PajamaLlamaLand/LessThanThree/GateDr/hardware/gateDr_displayboard/gateDr_displayboard.kicad_pcb

## KiCad design GateDr/hardware/gateDr_displayboard/gateDr_displayboard.kicad_pcb (2025-09-23)

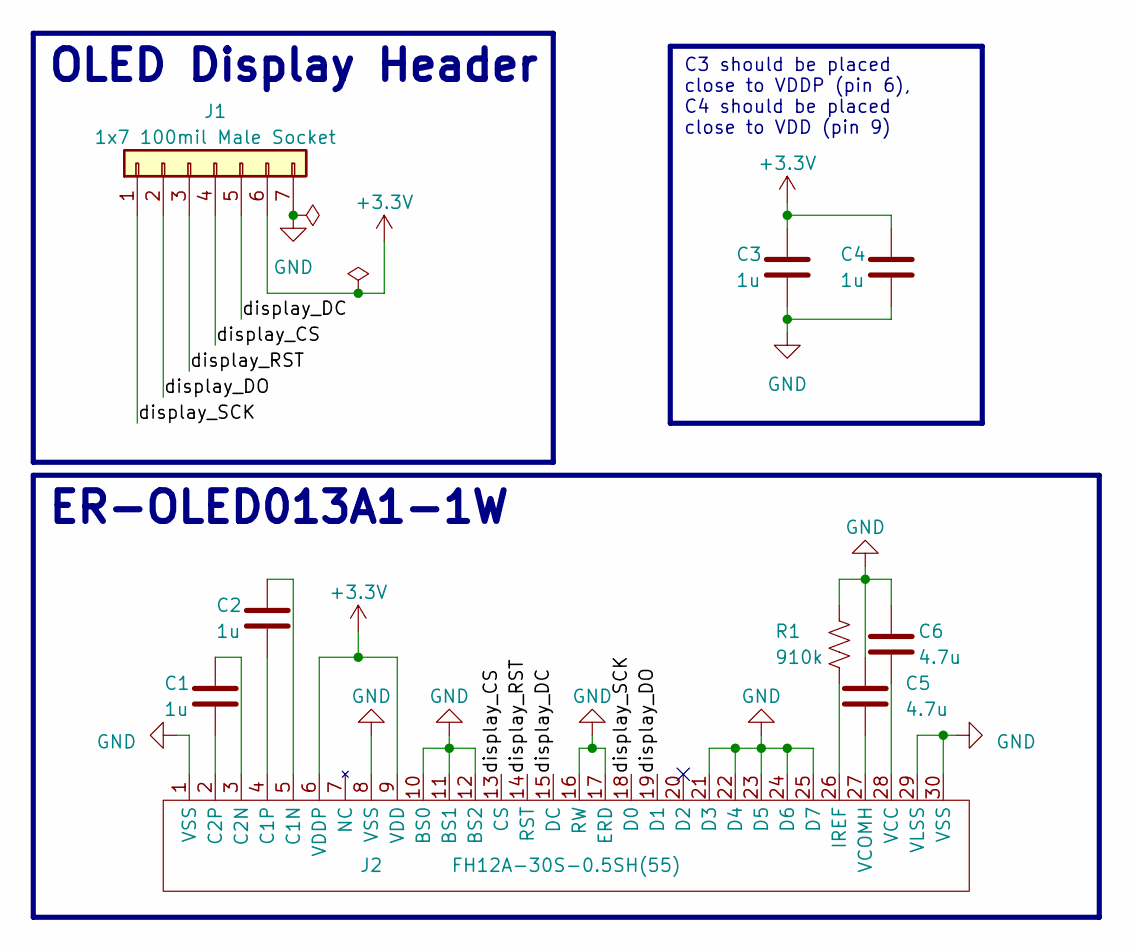
[picture p5: schematic gateDr_displayboard.kicad_sch]

Parts:
C1, C2, C3, C4: 1u; C_0603_1608Metric; Mouser Part No. GCM188R71E105KA64D
C5, C6: 4.7u; C_0603_1608Metric; Mouser Part No. GRM188Z71C475KE21D
J1: 1x7 100mil Male Socket; PinHeader_1x07_P2.54mm_Vertical
J2: FH12A-30S-0.5SH(55); FH12A-30S-0.5SH
R1: 910k; R_0402_1005Metric; Mouser Part No. CRCW0402910KFKED

Connections:
+3.3V: C3.1, C4.1, J1.6, J2.6 (VDDP), J2.9 (VDD)
/display_CS: J1.4, J2.13 (CS)
/display_DC: J1.5, J2.15 (DC)
/display_DO: J1.2, J2.19 (D1)
/display_RST: J1.3, J2.14 (RST)
/display_SCK: J1.1, J2.18 (D0)
GND: C3.2, C4.2, C5.1, C6.1, J1.7, J2.1 (VSS), J2.8 (VSS), J2.10 (BS0), J2.11 (BS1), J2.12 (BS2), J2.16 (RW), J2.17 (ERD), J2.21 (D3), J2.22 (D4), J2.23 (D5), J2.24 (D6), J2.25 (D7), J2.29 (VLSS), J2.30 (VSS), R1.1
unnamed: C2.1, J2.5 (C1N)
unnamed: C2.2, J2.4 (C1P)
unnamed: C1.1, J2.3 (C2N)
unnamed: C1.2, J2.2 (C2P)
unnamed: J2.26 (IREF), R1.2
unnamed: C6.2, J2.28 (VCC)
unnamed: C5.2, J2.27 (VCOMH)

Notes on the sheet:
ER-OLED013A1-1W
C3 should be placed close to VDDP (pin 6), C4 should be placed close to VDD (pin 9)
OLED Display Header

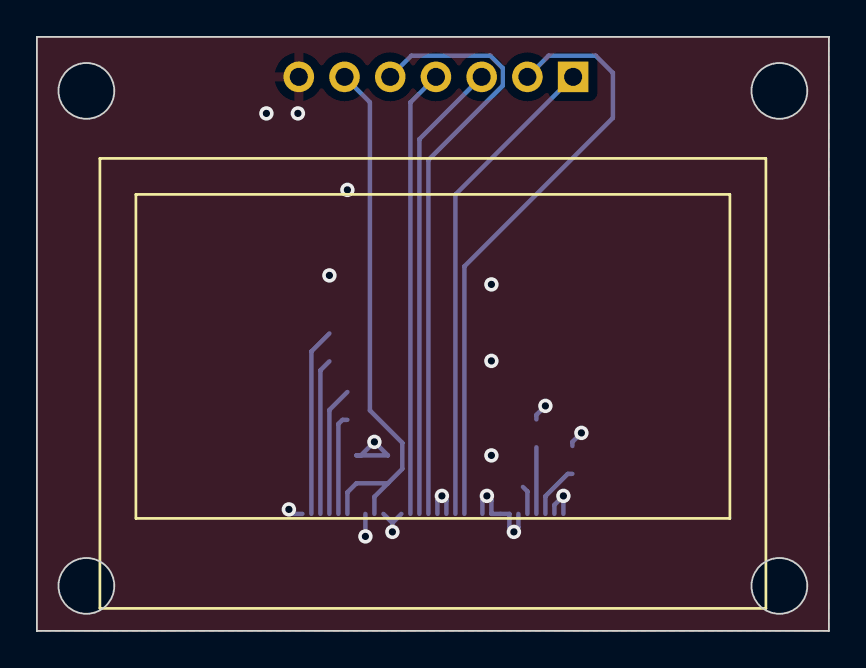
[picture p6: board gateDr_displayboard.kicad_pcb from above]

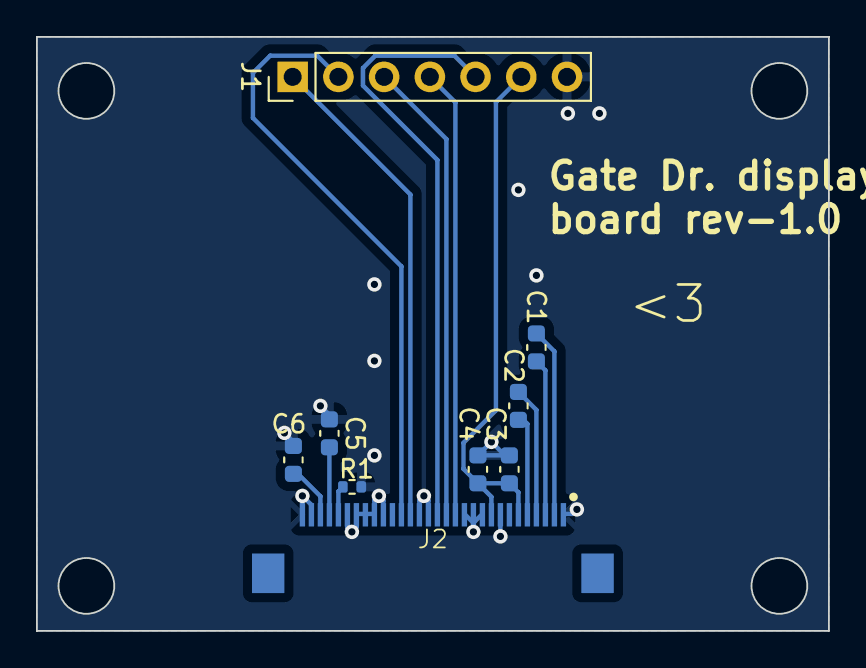
[picture p7: board gateDr_displayboard.kicad_pcb from below]

Board: 2 copper layers, 44.0 x 33.0 mm, 9 parts (9 on the bottom side), 14 nets.
