PajamaLlamaLand/LessThanThree/GateDr/hardware/gateDr_mainboard/gateDr_mainboard.kicad_pcb

## KiCad design GateDr/hardware/gateDr_mainboard/gateDr_mainboard.kicad_pcb (2025-09-23)

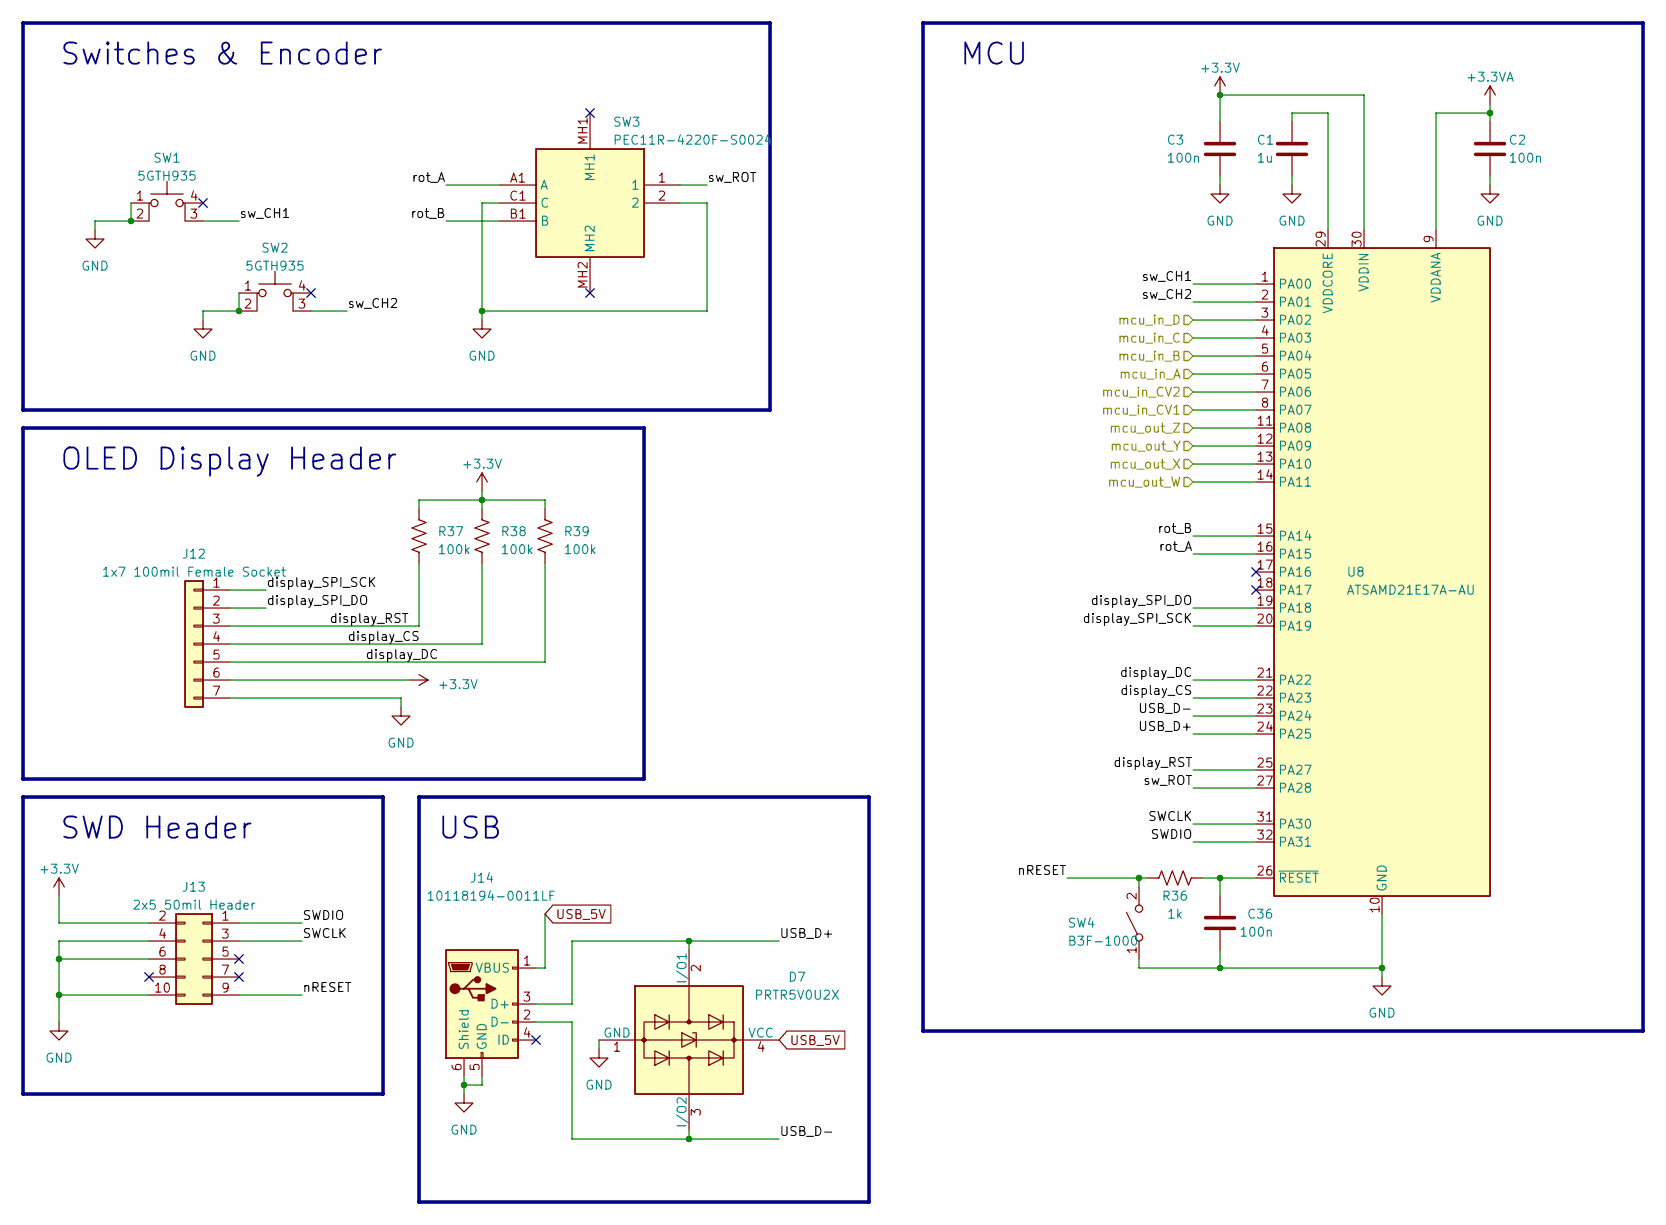
[picture p8: schematic mcu.kicad_sch]

Parts:
C1: 1u; C_0603_1608Metric; Mouser Part No. GCM188R71E105KA64D
C2, C3, C36: 100n; C_0402_1005Metric; Mouser Part No. GRM155R71H104KE14J
D7: PRTR5V0U2X; SOT-143; Mouser Part No. 771-PRTR5V0U2X-T/R
J12: 1x7 100mil Female Socket; PinSocket_1x07_P2.54mm_Vertical
J13: 2x5 50mil Header; PinSocket_2x05_P1.27mm_Vertical
J14: 10118194-0011LF; USB_Micro-B_Amphenol_10118194_Horizontal; Mouser Part No. 649-10118194-0011LF
R36: 1k; R_0402_1005Metric; Mouser Part No. CRCW04021K00FKED
R37, R38, R39: 100k; R_0402_1005Metric; Mouser Part No. CRCW0402100KFKED
SW1, SW2: 5GTH935
SW3: PEC11R-4220F-S0024; PEC11R4220FS0024; Mouser Part Number 652-PEC11R-4220F-S24
SW4: B3F-1000; SW_PUSH_6mm_H4.3mm
U8: ATSAMD21E17A-AU; TQFP-32_7x7mm_P0.8mm

Connections:
+3.3V: C3.1, J12.6, J13.2, R37.1, R38.1, R39.1, U8.30 (VDDIN); also elsewhere on the board
+3.3VA: C2.1, U8.9 (VDDANA); also elsewhere on the board
/Inputs/in_A: U8.6 (PA05); also elsewhere on the board
/Inputs/in_B: U8.5 (PA04); also elsewhere on the board
/Inputs/in_C: U8.4 (PA03); also elsewhere on the board
/Inputs/in_CV1: U8.8 (PA07); also elsewhere on the board
/Inputs/in_CV2: U8.7 (PA06); also elsewhere on the board
/Inputs/in_D: U8.3 (PA02); also elsewhere on the board
/MCU/SWCLK: J13.3, U8.31 (PA30)
/MCU/SWDIO: J13.1, U8.32 (PA31)
/MCU/USB_D+: D7.2 (I/O1), J14.3 (D+), U8.24 (PA25)
/MCU/USB_D-: D7.3 (I/O2), J14.2 (D-), U8.23 (PA24)
/MCU/display_CS: J12.4, R38.2, U8.22 (PA23)
/MCU/display_DC: J12.5, R39.2, U8.21 (PA22)
/MCU/display_RST: J12.3, R37.2, U8.25 (PA27)
/MCU/display_SPI_DO: J12.2, U8.19 (PA18)
/MCU/display_SPI_SCK: J12.1, U8.20 (PA19)
/MCU/mcu_out_W: U8.14 (PA11); also elsewhere on the board
/MCU/mcu_out_X: U8.13 (PA10); also elsewhere on the board
/MCU/mcu_out_Y: U8.12 (PA09); also elsewhere on the board
/MCU/mcu_out_Z: U8.11 (PA08); also elsewhere on the board
/MCU/nRESET: J13.9, R36.1, SW4.2 (B)
/MCU/rot_A: SW3.A1 (A), U8.16 (PA15)
/MCU/rot_B: SW3.B1 (B), U8.15 (PA14)
/MCU/sw_CH1: SW1.3 (K), U8.1 (PA00)
/MCU/sw_CH2: SW2.3 (K), U8.2 (PA01)
/MCU/sw_ROT: SW3.1, U8.27 (PA28)
GND: C1.2, C2.2, C3.2, C36.2, D7.1 (GND), J12.7, J13.4, J13.6, J13.10, J14.5 (GND), J14.6 (Shield), SW1.1, SW1.2, SW2.1, SW2.2, SW3.2, SW3.C1 (C), SW4.1 (A), U8.10 (GND), U8.28 (GND); also elsewhere on the board
unnamed: C1.1, U8.29 (VDDCORE)
unnamed: C36.1, R36.2, U8.26 (~RESET)
USB_5V: D7.4 (VCC), J14.1 (VBUS); also elsewhere on the board

Notes on the sheet:
Switches & Encoder
SWD Header
USB
OLED Display Header
MCU

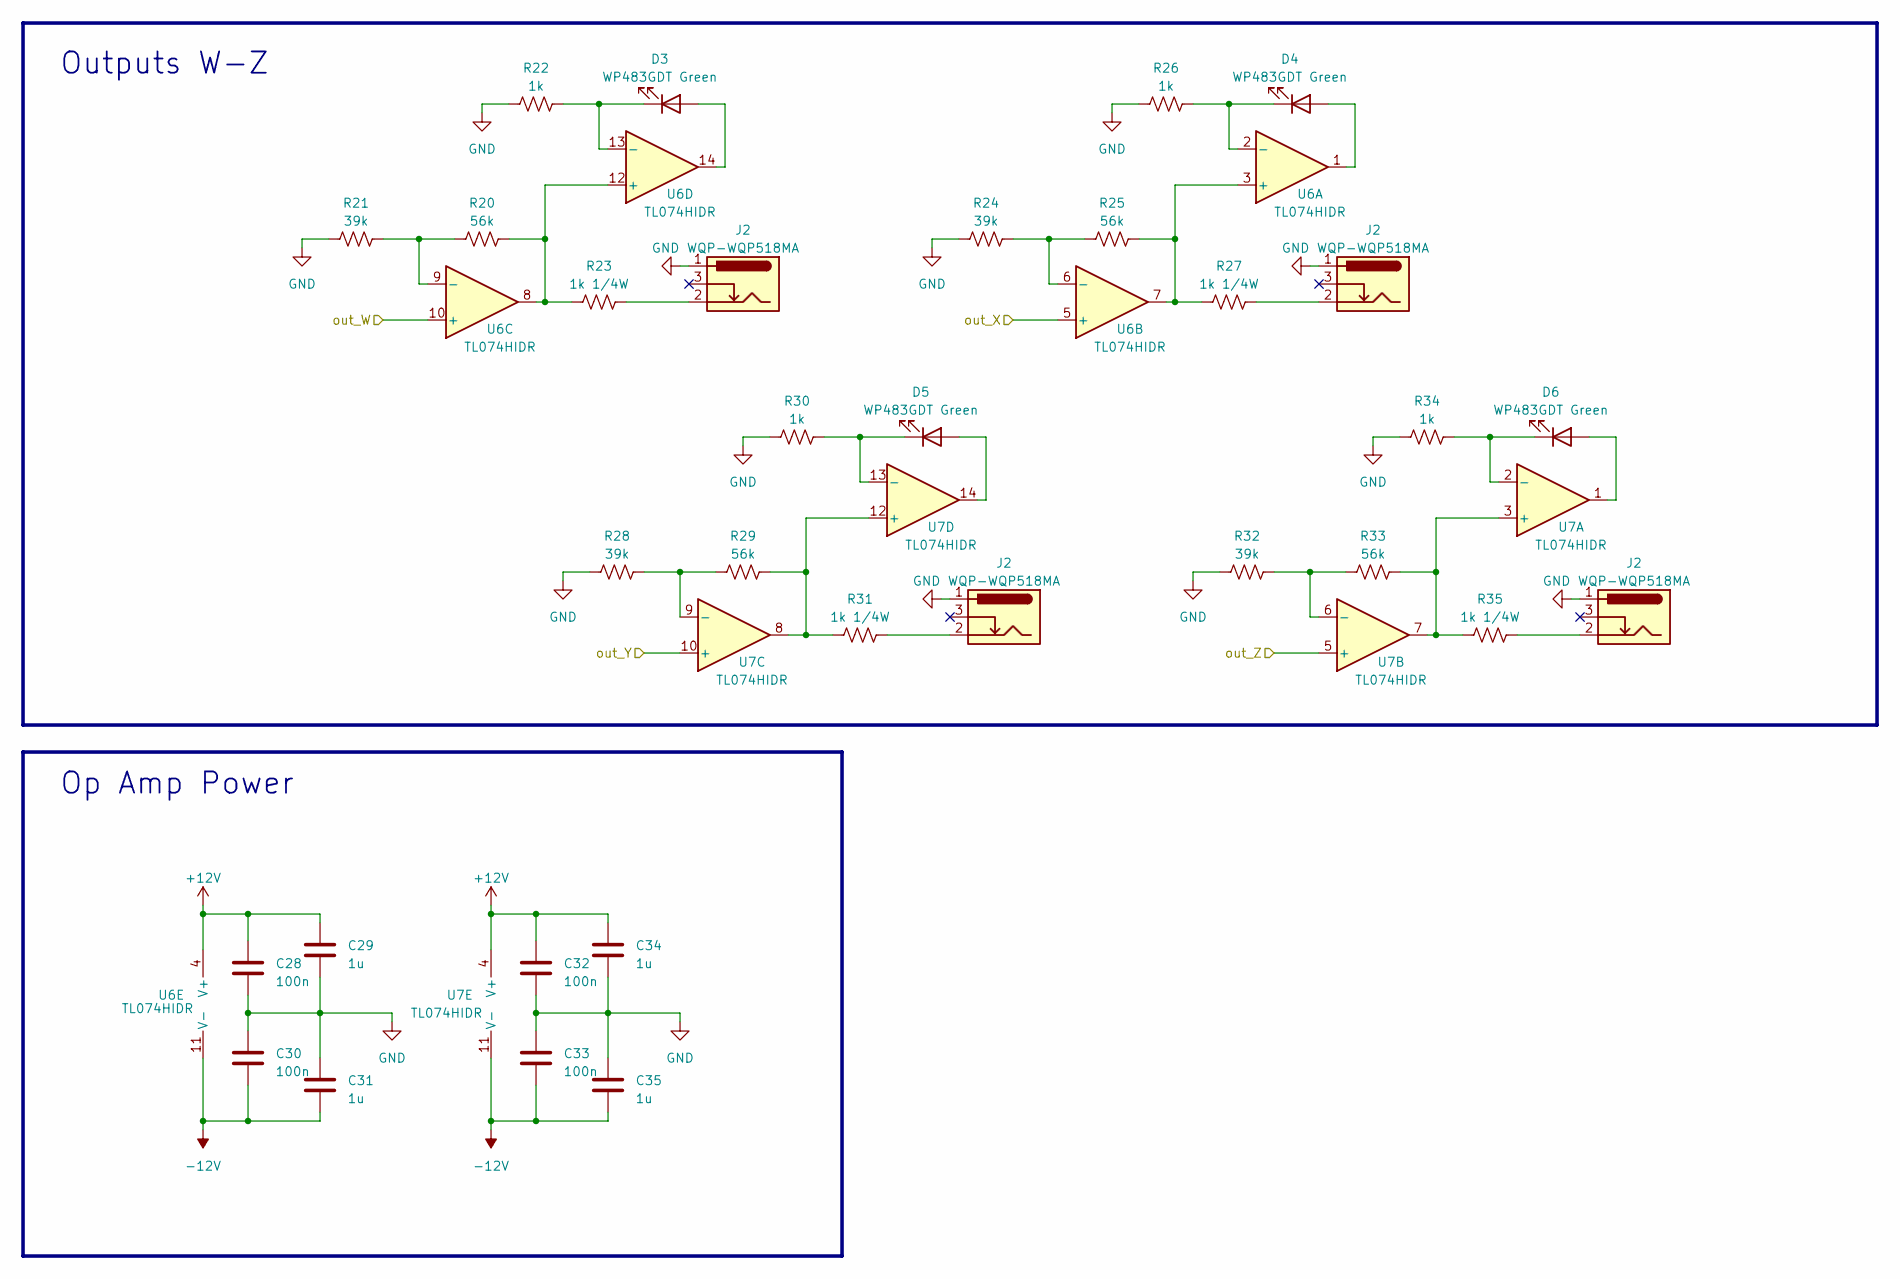
[picture p9: schematic outputs.kicad_sch]

Parts:
C28, C30, C32, C33: 100n; C_0402_1005Metric; Mouser Part No. GRM155R71H104KE14J
C29, C31, C34, C35: 1u; C_0603_1608Metric; Mouser Part No. GCM188R71E105KA64D
D3, D4, D5, D6: WP483GDT Green; LED_D5.0mm_FlatTop
J2: WQP-WQP518MA; AudioJack_WQP518MA
R20, R25, R29, R33: 56k; R_0402_1005Metric; Mouser Part No. CRCW040256K0FKED
R21, R24, R28, R32: 39k; R_0402_1005Metric; Mouser Part No. CRCW040239K0FKED
R22, R26, R30, R34: 1k; R_0402_1005Metric; Mouser Part No. CRCW04021K00FKED
R23, R27, R31, R35: 1k 1/4W; R_0805_2012Metric; Mouser Part No. RCC08051K00FKEA
U6, U7: TL074HIDR; SOIC-14_3.9x8.7mm_P1.27mm

Connections:
+12V: C28.1, C29.1, C32.1, C34.1, U6.4 (V+), U7.4 (V+); also elsewhere on the board
-12V: C30.2, C31.2, C33.2, C35.2, U6.11 (V-), U7.11 (V-); also elsewhere on the board
/MCU/mcu_out_W: U6.10 (+); also elsewhere on the board
/MCU/mcu_out_X: U6.5 (+); also elsewhere on the board
/MCU/mcu_out_Y: U7.10 (+); also elsewhere on the board
/MCU/mcu_out_Z: U7.5 (+); also elsewhere on the board
GND: C28.2, C29.2, C30.1, C31.1, C32.2, C33.1, C34.2, C35.1, J2.1, J2.3, R21.1, R22.1, R24.1, R26.1, R28.1, R30.1, R32.1, R34.1; also elsewhere on the board
unnamed: D3.2 (A), U6.14
unnamed: D3.1 (K), R22.2, U6.13 (-)
unnamed: D4.2 (A), U6.1
unnamed: D4.1 (K), R26.2, U6.2 (-)
unnamed: D5.2 (A), U7.14
unnamed: D5.1 (K), R30.2, U7.13 (-)
unnamed: D6.2 (A), U7.1
unnamed: D6.1 (K), R34.2, U7.2 (-)
unnamed: R25.2, R27.1, U6.3 (+), U6.7
unnamed: R24.2, R25.1, U6.6 (-)
unnamed: R20.1, R21.2, U6.9 (-)
unnamed: R20.2, R23.1, U6.8, U6.12 (+)
unnamed: R33.2, R35.1, U7.3 (+), U7.7
unnamed: R32.2, R33.1, U7.6 (-)
unnamed: R28.2, R29.1, U7.9 (-)
unnamed: R29.2, R31.1, U7.8, U7.12 (+)

Notes on the sheet:
Op Amp Power
Outputs W-Z

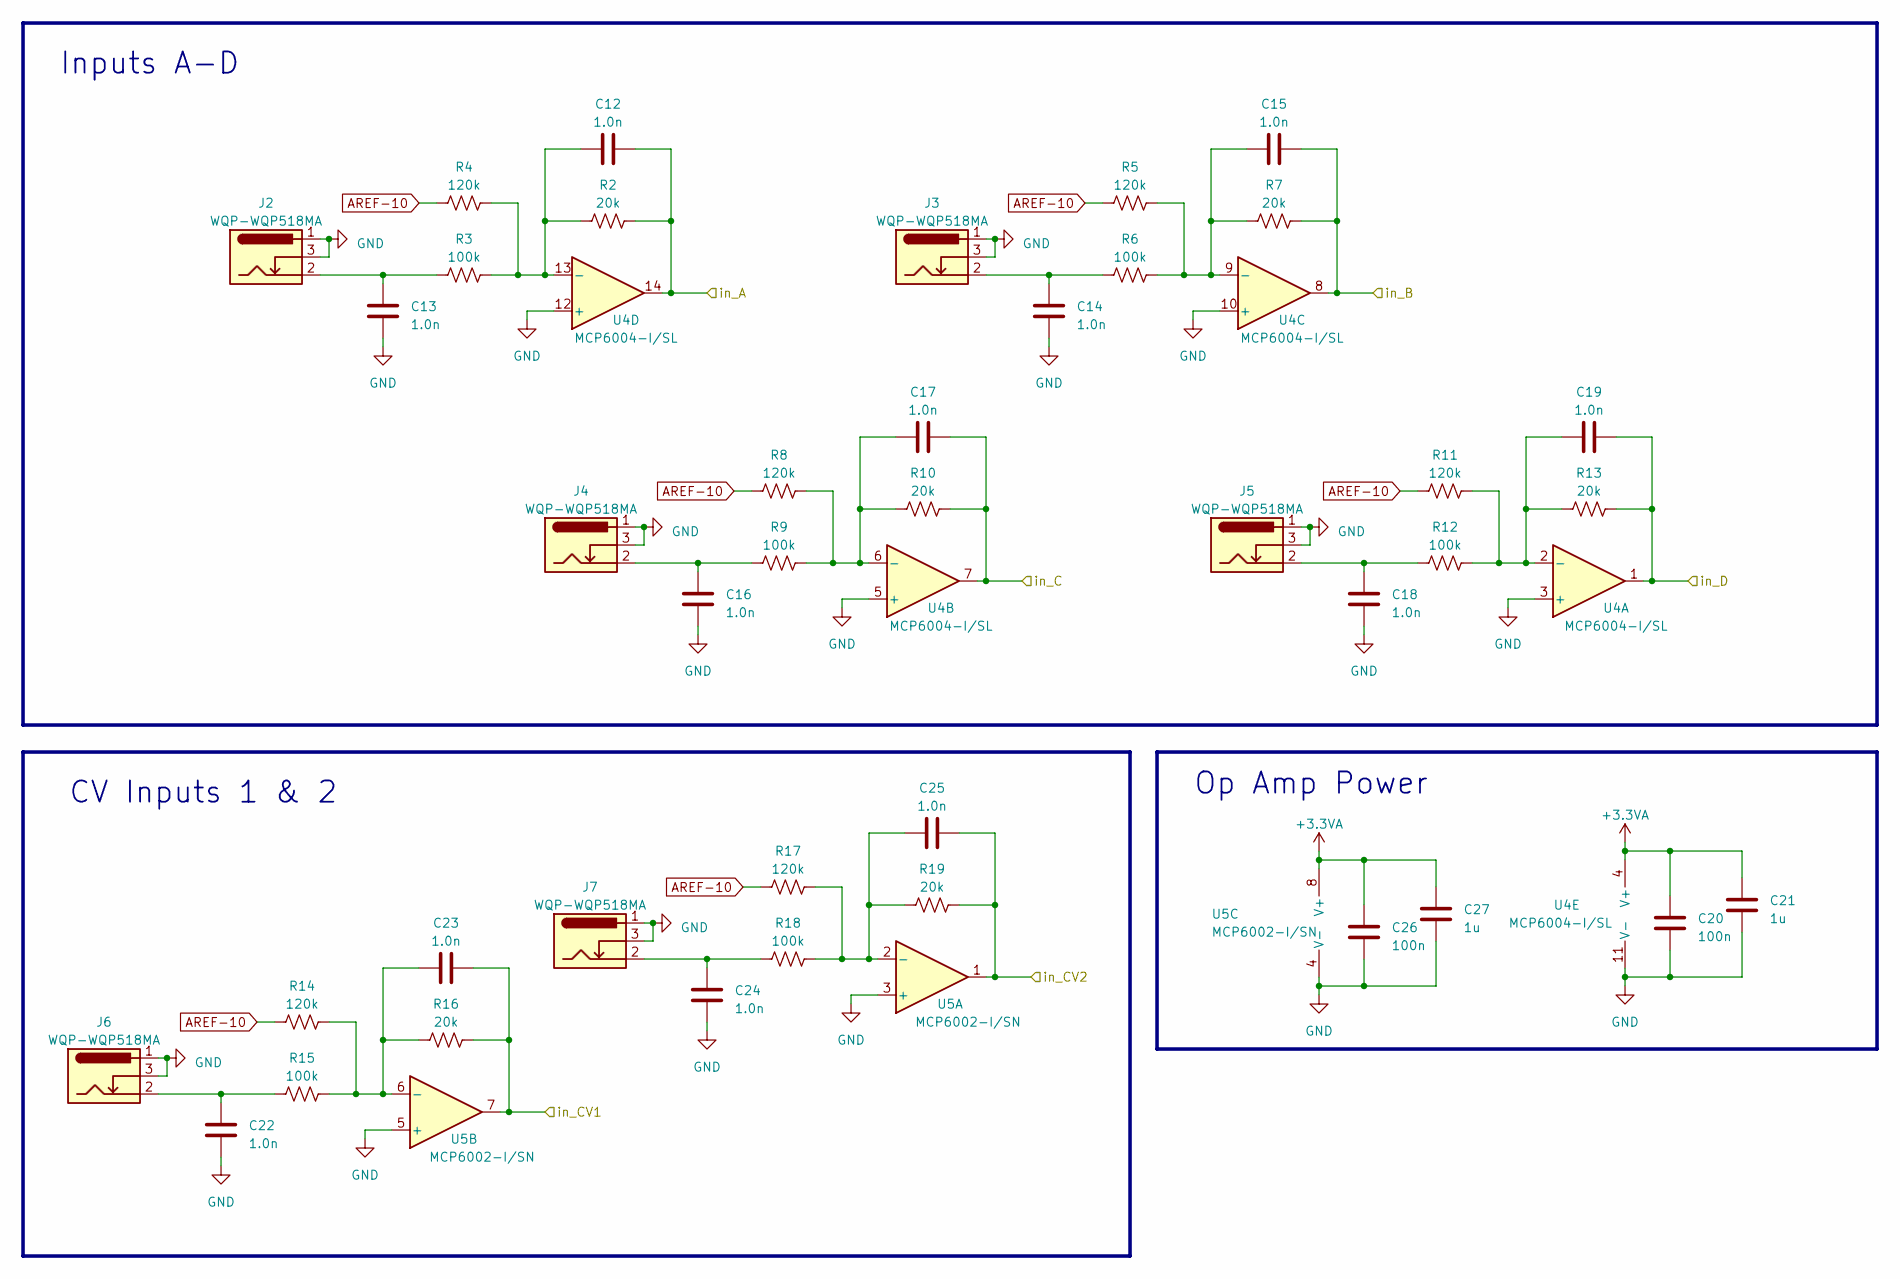
[picture p10: schematic inputs.kicad_sch]

Parts:
C12, C13, C14, C15, C16, C17, C18, C19, C22, C23, C24, C25: 1.0n; C_0402_1005Metric; Mouser Part No. GRM155R71H102KA01J
C20, C26: 100n; C_0402_1005Metric; Mouser Part No. GRM155R71H104KE14J
C21, C27: 1u; C_0603_1608Metric; Mouser Part No. GCM188R71E105KA64D
J2, J3, J4, J5, J6, J7: WQP-WQP518MA; AudioJack_WQP518MA
R2, R7, R10, R13, R16, R19: 20k; R_0402_1005Metric; Mouser Part No. CRCW040220K0FKED
R3, R6, R9, R12, R15, R18: 100k; R_0402_1005Metric; Mouser Part No. CRCW0402100KFKED
R4, R5, R8, R11, R14, R17: 120k; R_0402_1005Metric; Mouser Part No. CRCW0402120KFKED
U4: MCP6004-I/SL; SOIC-14_3.9x8.7mm_P1.27mm
U5: MCP6002-I/SN; SOIC-8_3.9x4.9mm_P1.27mm

Connections:
+3.3VA: C20.1, C21.1, C26.1, C27.1, U4.4 (V+), U5.8 (V+); also elsewhere on the board
/Inputs/in_A: C12.2, R2.2, U4.14; also elsewhere on the board
/Inputs/in_B: C15.2, R7.2, U4.8; also elsewhere on the board
/Inputs/in_C: C17.2, R10.2, U4.7; also elsewhere on the board
/Inputs/in_CV1: C23.2, R16.2, U5.7; also elsewhere on the board
/Inputs/in_CV2: C25.2, R19.2, U5.1; also elsewhere on the board
/Inputs/in_D: C19.2, R13.2, U4.1; also elsewhere on the board
AREF-10: R4.1, R5.1, R8.1, R11.1, R14.1, R17.1; also elsewhere on the board
GND: C13.2, C14.2, C16.2, C18.2, C20.2, C21.2, C22.2, C24.2, C26.2, C27.2, J2.1, J2.3, J3.1, J3.3, J4.1, J4.3, J5.1, J5.3, J6.1, J6.3, J7.1, J7.3, U4.3 (+), U4.5 (+), U4.10 (+), U4.11 (V-), U4.12 (+), U5.3 (+), U5.4 (V-), U5.5 (+); also elsewhere on the board
unnamed: C14.1, J3.2, R6.1
unnamed: C16.1, J4.2, R9.1
unnamed: C18.1, J5.2, R12.1
unnamed: C22.1, J6.2, R15.1
unnamed: C24.1, J7.2, R18.1
unnamed: C19.1, R11.2, R12.2, R13.1, U4.2 (-)
unnamed: C17.1, R8.2, R9.2, R10.1, U4.6 (-)
unnamed: C15.1, R5.2, R6.2, R7.1, U4.9 (-)
unnamed: C12.1, R2.1, R3.2, R4.2, U4.13 (-)
unnamed: C25.1, R17.2, R18.2, R19.1, U5.2 (-)
unnamed: C23.1, R14.2, R15.2, R16.1, U5.6 (-)

Notes on the sheet:
Inputs A-D
CV Inputs 1 & 2
Op Amp Power

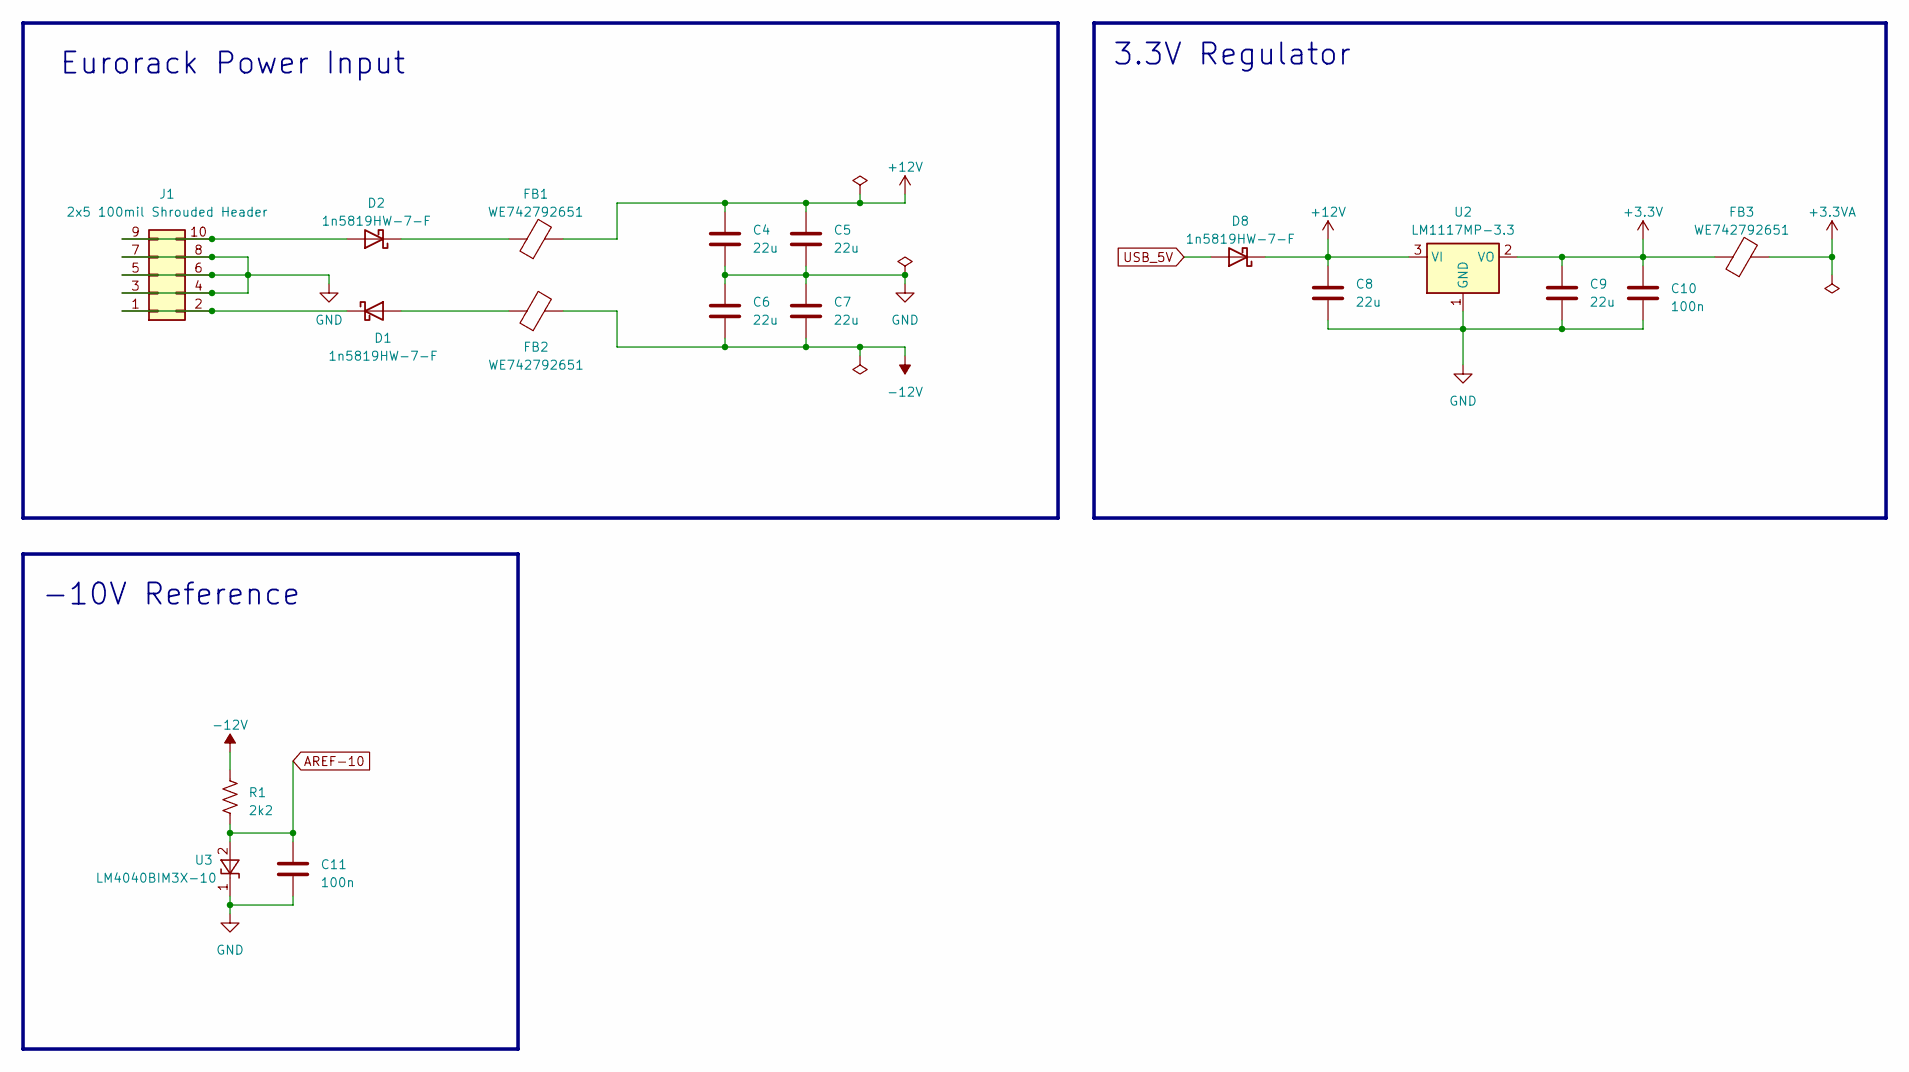
[picture p11: schematic power.kicad_sch]

Parts:
C4, C5, C6, C7, C8, C9: 22u; C_0805_2012Metric; Mouser Part No. CL21A226MAYNNNE
C10, C11: 100n; C_0402_1005Metric; Mouser Part No. GRM155R71H104KE14J
D1, D2, D8: 1n5819HW-7-F; D_SOD-123
FB1, FB2, FB3: WE742792651; BEADC1608X100N
J1: 2x5 100mil Shrouded Header; IDC-Header_2x05_P2.54mm_Vertical
R1: 2k2; R_0402_1005Metric; Mouser Part No. CRCW04022K20FKED
U2: LM1117MP-3.3; SOT-223-3_TabPin2
U3: LM4040BIM3X-10; SOT-23

Connections:
+3.3V: C9.1, C10.1, FB3.1, U2.2 (VO); also elsewhere on the board
+3.3VA: FB3.2; also elsewhere on the board
+12V: C4.1, C5.1, C8.1, D8.1 (K), FB1.2, U2.3 (VI); also elsewhere on the board
-12V: C6.2, C7.2, FB2.2, R1.1; also elsewhere on the board
AREF-10: C11.1, R1.2, U3.2 (A); also elsewhere on the board
GND: C4.2, C5.2, C6.1, C7.1, C8.2, C9.2, C10.2, C11.2, J1.3, J1.4, J1.5, J1.6, J1.7, J1.8, U2.1 (GND), U3.1 (K); also elsewhere on the board
unnamed: D1.2 (A), FB2.1
unnamed: D1.1 (K), J1.1, J1.2
unnamed: D2.2 (A), J1.9, J1.10
unnamed: D2.1 (K), FB1.1
USB_5V: D8.2 (A); also elsewhere on the board

Notes on the sheet:
-10V Reference
3.3V Regulator
Eurorack Power Input

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
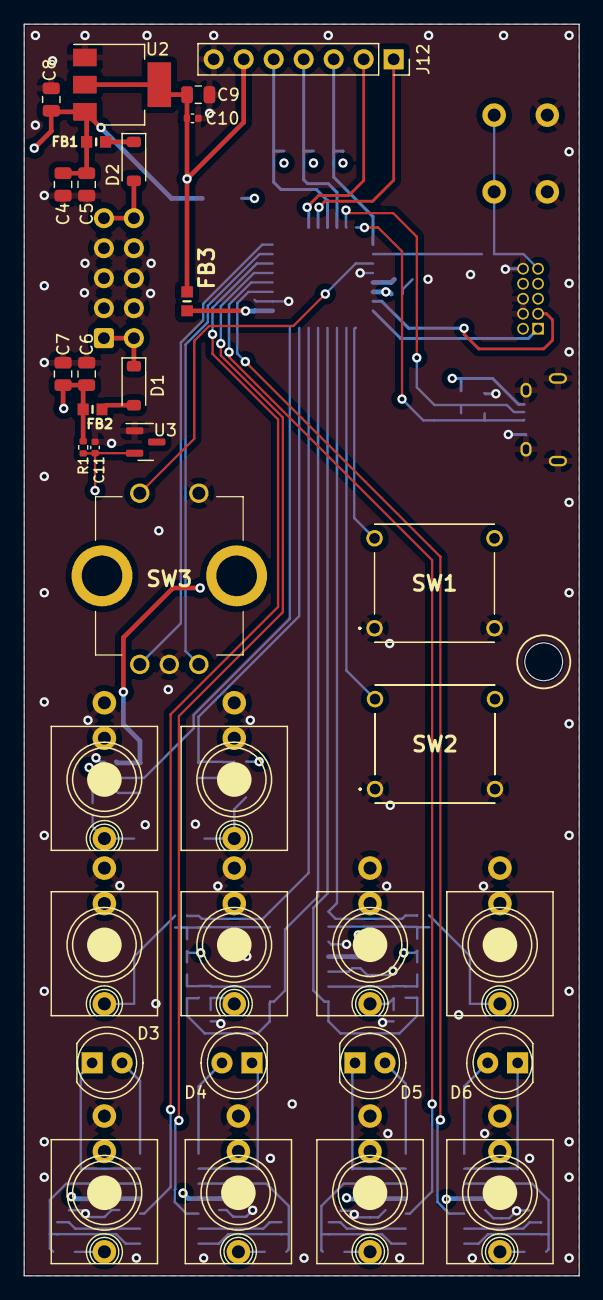
[picture p12: board gateDr_mainboard.kicad_pcb from above]

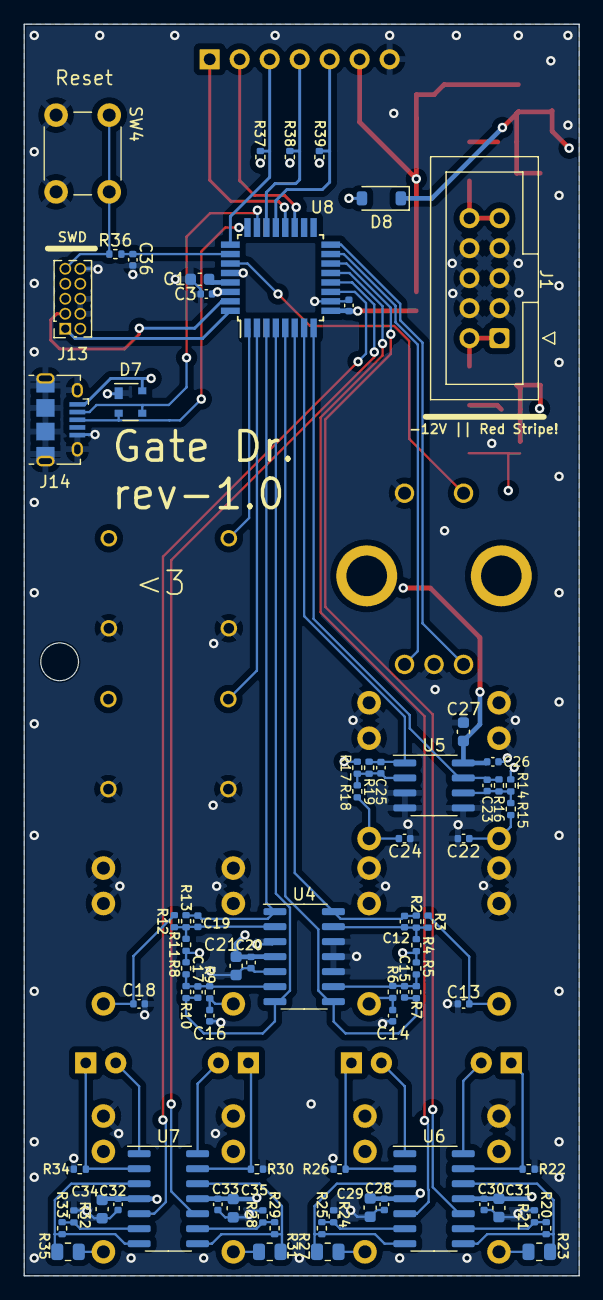
[picture p13: board gateDr_mainboard.kicad_pcb from below]

Board: 4 copper layers, 47.0 x 106.0 mm, 111 parts (77 on the bottom side), 70 nets.

Other parts of the board:
J8, J9, J10, J11: WQP-WQP518MA; AudioJack_WQP518MA

Their connections:
GND: J8.1, J9.1, J10.1, J11.1; also elsewhere on the board
