PajamaLlamaLand/LessThanThree/GateDr/firmware/GateDr_v0.1/src/gateDr.h

/*
 *	includes for the Gate Dr. project
 */ 


#ifndef GATEDR_H_
#define GATEDR_H_


#include "inputs.h"
#include "operations.h"
#include "outputs.h"
#include "channel.h"
#include "cv.h"
#include "ui.h"
#include "menu.h"
#include "globalSettings.h"


#endif /* GATEDR_H_ */
